cvra/carte-alim/Gerber/Seeedtudio_param.png

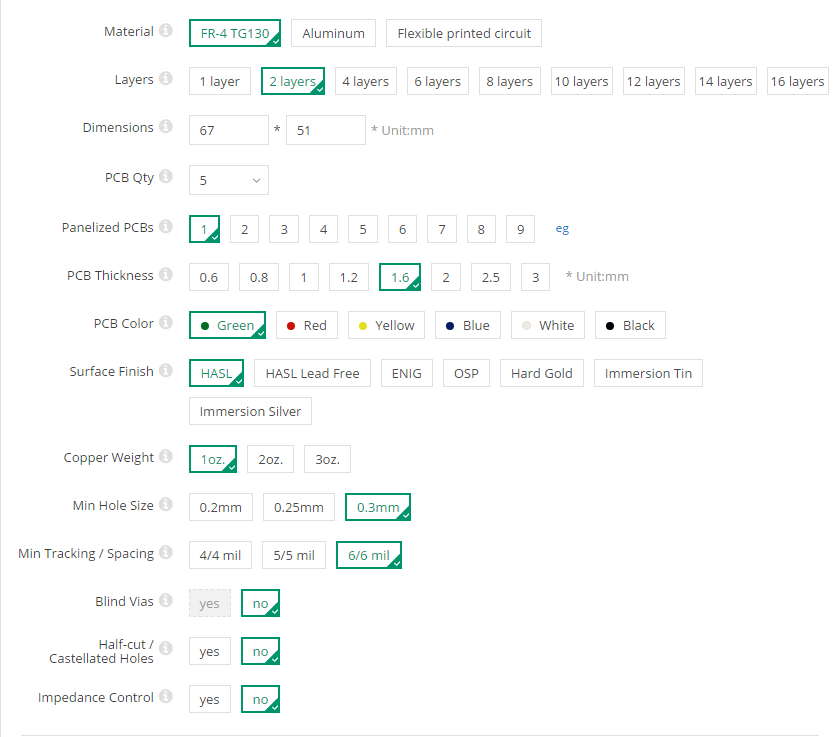
Gerber/Seeedtudio_param.png
