cvra/carte-alim/img/PCB_CarteAlim2017.png

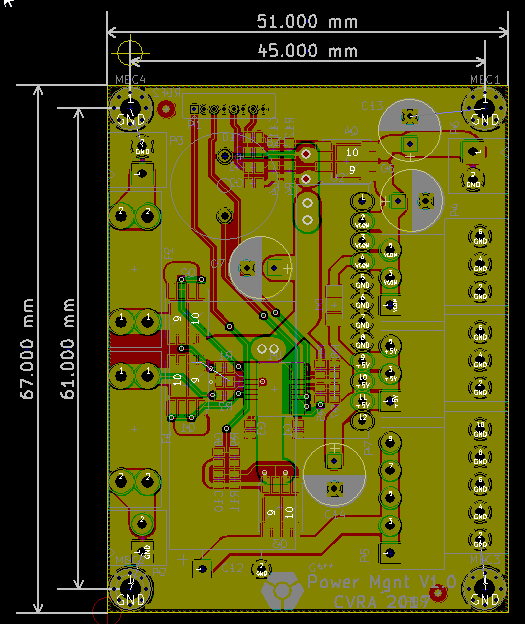
img/PCB_CarteAlim2017.png
