cvra/carte-alim/BOM_CarteAlim2017.xlsx

Id | Référence | Boîtier | Qu/PCB | Qu à cmd | Designation | Fournisseur | No Fournisseur
1 | C1,C3 | _0603 | 2 | 0 | NC
2 | C2,C8,C9 | _0603 | 3 | 9 | 1nF | Digikey | 478-1215-1-ND
3 | C4,C10,C11 | _0603 | 3 | 0 | 47nF | Digikey | 311-1427-1-ND
4 | C5 | _0603 | 1 | 0 | 0.1uF | Digikey | 399-5089-1-ND
5 | C6,C7,C13,C14 | CP_Radial_D8.0mm_P3.50mm | 4 | 12 | 100uF | Digikey | P12392-ND
6 | C12 | CP_Radial_L31.50D16.00P7.50_H | 1 | 3 | 3.3mF | Digikey | 565-3927-ND
7 | D1 | D_MiniMELF_Standard | 1 | 0 | LL103C-GS08 | Digikey | LL103C-GS08CT-ND
8 | F1,F2 | FuseHolder-Keystone-3557-2 | 2 | 6 | 20A | Digikey | 36-3557-2-ND
9 | P1 | Molex-PicoBlade-8 | 1 | 3 | Picoblade | Digikey | WM1737-ND
10 | P2,P3,P6 | Bornier_2p_3.5H | 3 | 0 | PT 1,5/ 2-3,5-H | Phoenix Contact
11 | P4,P7 | _Pheonix_MKKDS-1-3-3.5mm | 2 | 0 | MKKDS 1/ 3-3,5 | Phoenix Contact
12 | P5 | _Pheonix_MKKDS-1-5-3.5mm | 1 | 0 | MKKDS 1/ 5-3,5 | Phoenix Contact
13 | R1,R2 | _0603 | 2 | 6 | 1k | Digikey | 311-1.00KHRCT-ND
14 | R3,R4,R9,R10,R11,R12 | _0603 | 6 | 0 | 100k | Digikey | 311-100KHRCT-ND
15 | R5,R6,R7,R8 | _0603 | 4 | 12 | R | Digikey
16 | U1 | TSSOP-20_4.4x6.5mm_Pitch0.65mm | 1 | 3 | LTC2952_TSSOP20 | Digikey | LTC2952CF#PBF-ND
17 | U2 | DCDC-Conv_Recom_R-5xxxPA | 1 | 3 | R-555.0PA | Digikey | 945-2315-5-ND
20 | Q1,Q2,Q3,Q4 | PowerPak-SO8_5.15x6.15mm_Pitch1.27mm | 4 | 12 | Si7997DP | Digikey | SI7997DP-T1-GE3CT-ND
22 | BZ1 | _Buzzer_PUIAudio_AI-1433-TWT-R | 1 | 3 | Buzzer | Digikey | 668-1341-ND
 | P1 | Molex Picoblade 8 pin connector | 1 | 0 |  | Digikey | WM1726-ND
 | P1 | Contact picoblade 50079-8100 | 8 | 0 |  | Digikey | WM2023-ND
