cvra/carte-alim/CarteAlim2012.pdf

## Lipo 2...4S

6...16.8V

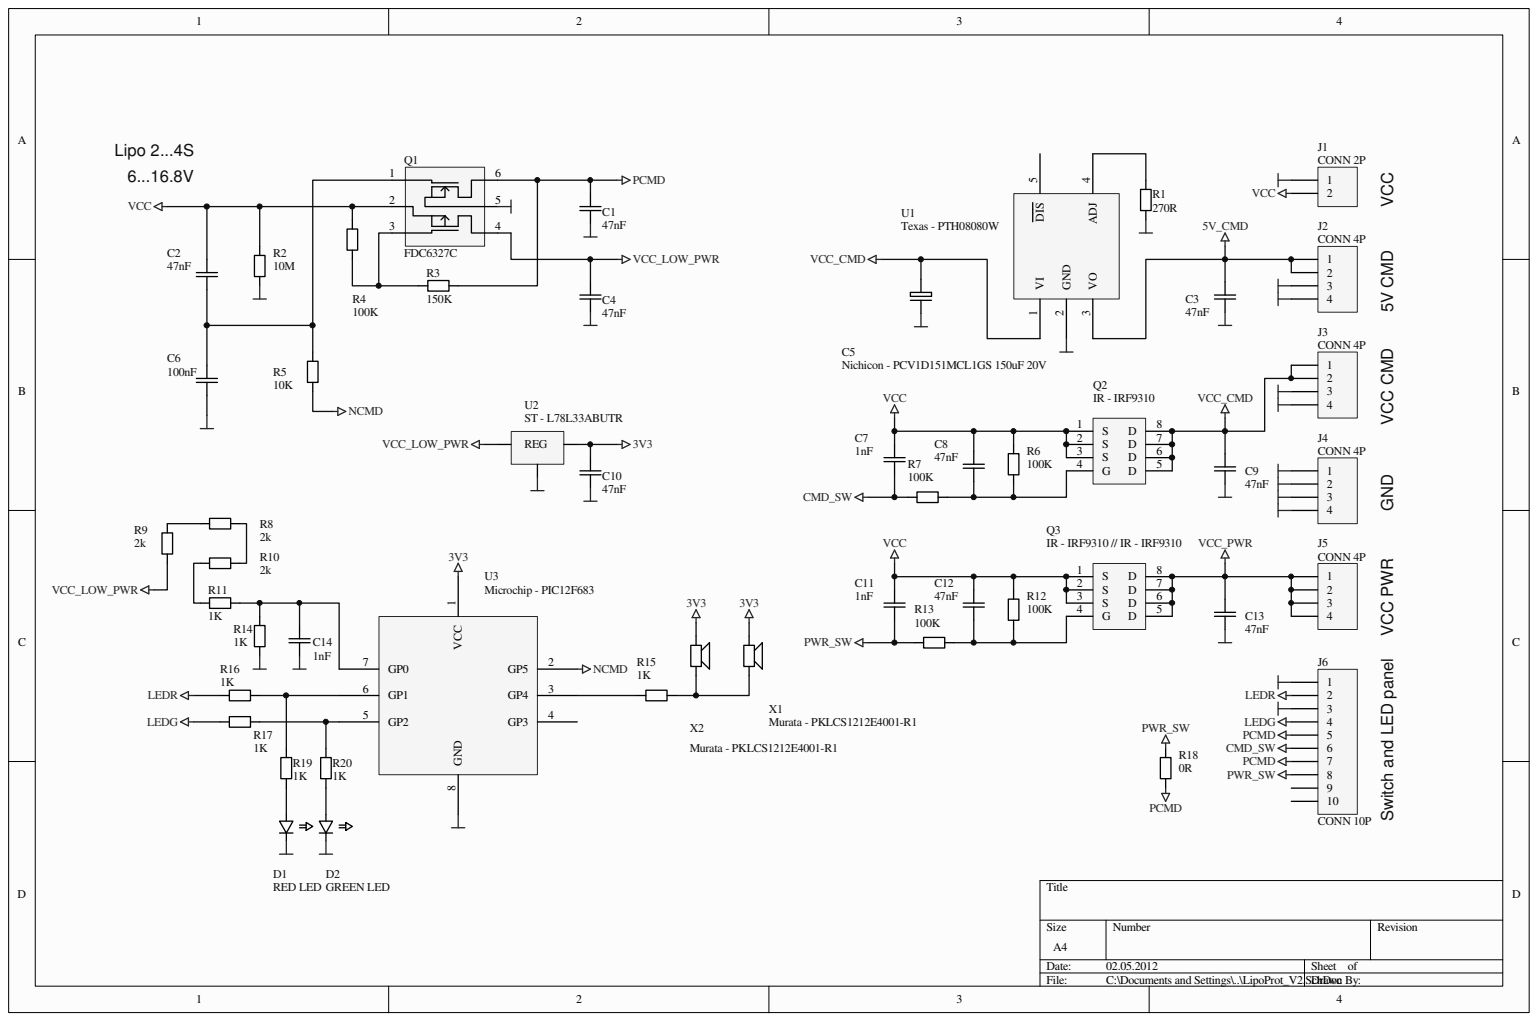
[picture p3: page 1]

Switch and LED panel
