cvra/carte-alim/CarteAlim2017.pdf

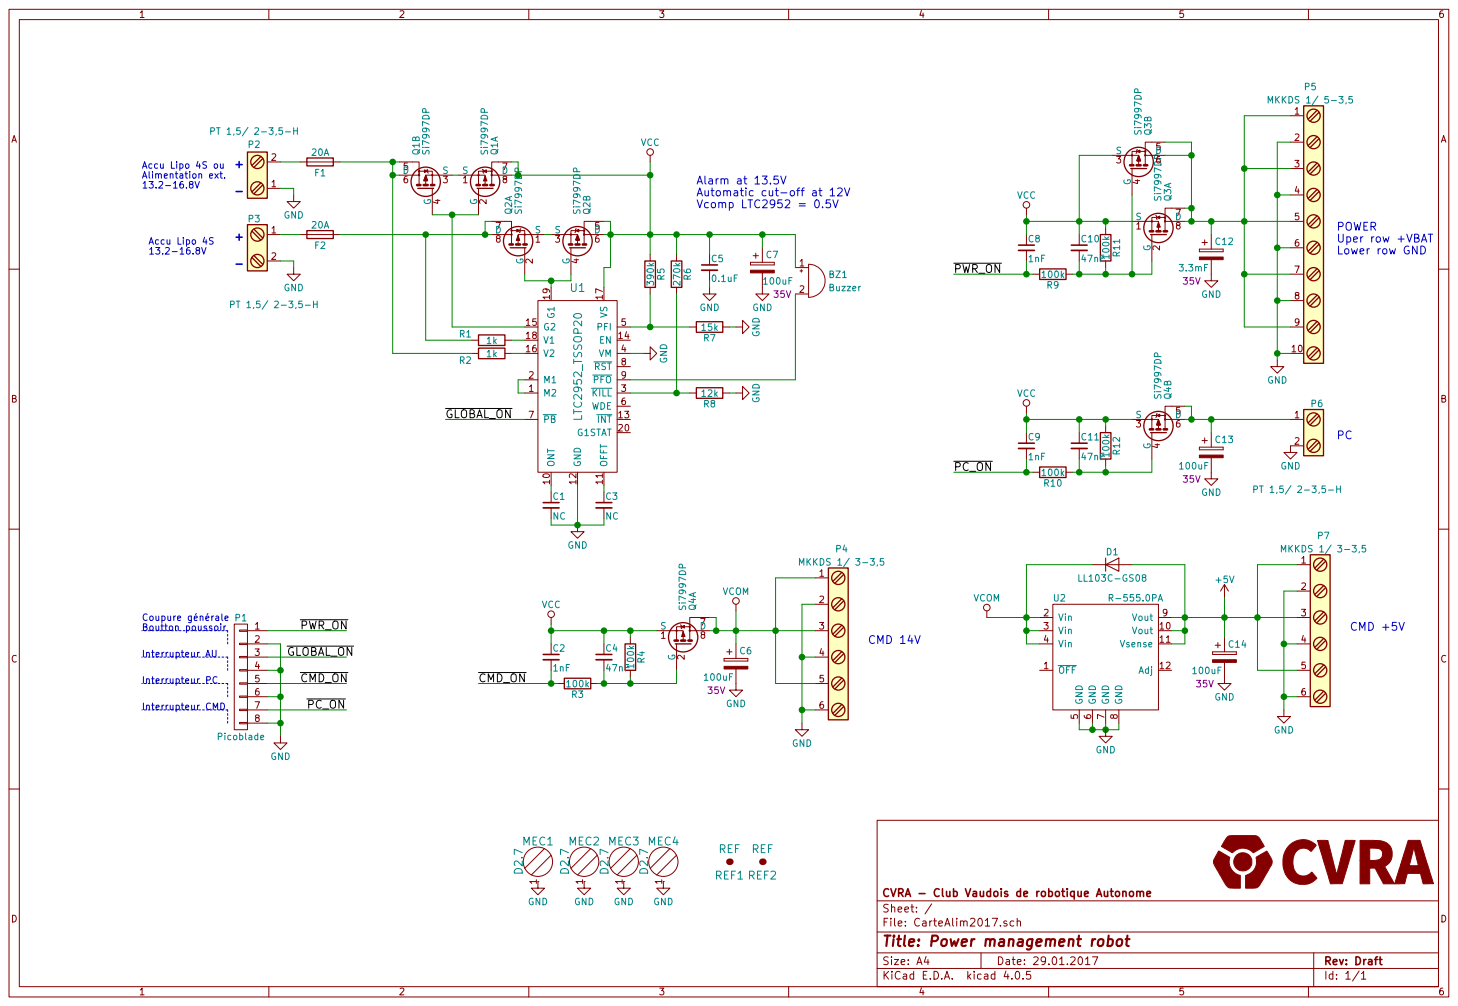
[picture p4: page 1]

Automatic cut-off at 12V
Vcomp LTC2952 = 0.5V

8 Vout 9 Vout 10 Vsense 11 Adj 12 U2 R-555.0PA GND

1 MEC4 D2.7 GND GND GND GND REF1 REF REF2 REF

Id: 1/1 Title: Power management robot File: CarteAlim2017.sch Sheet: / CVRA - Club Vaudois de robotique Autonome
