cvra/carte-alim/img/Assembly_bottom.pdf

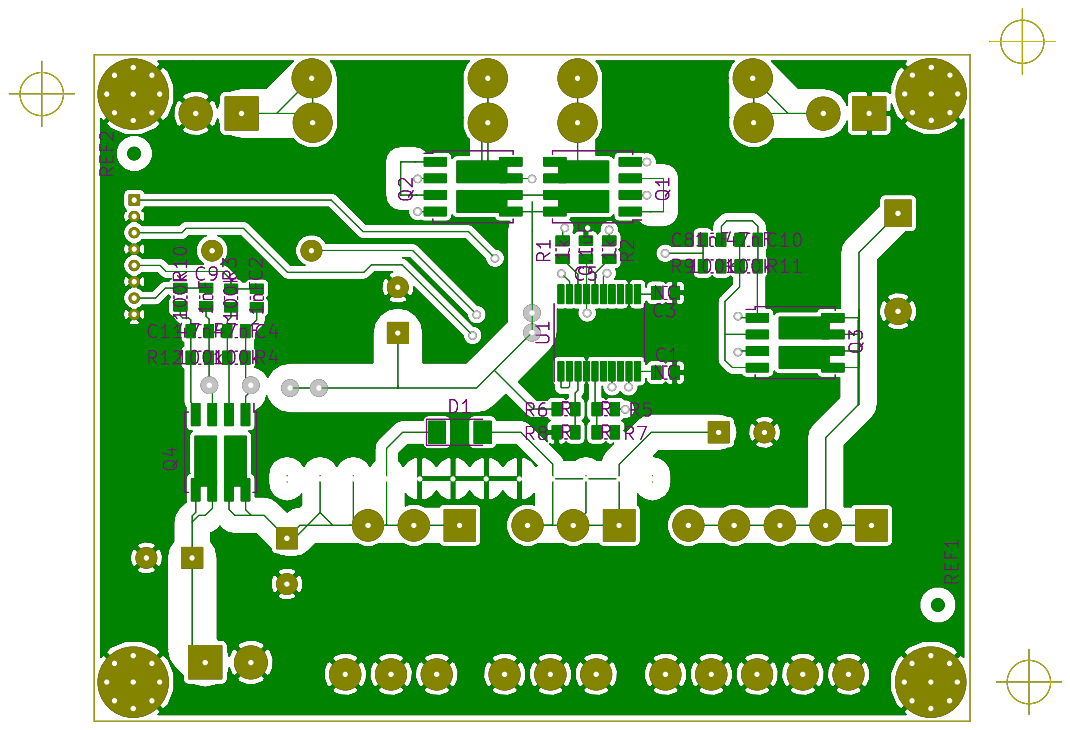
[picture p5: page 1]
