cvra/carte-alim/img/Assembly_top.pdf

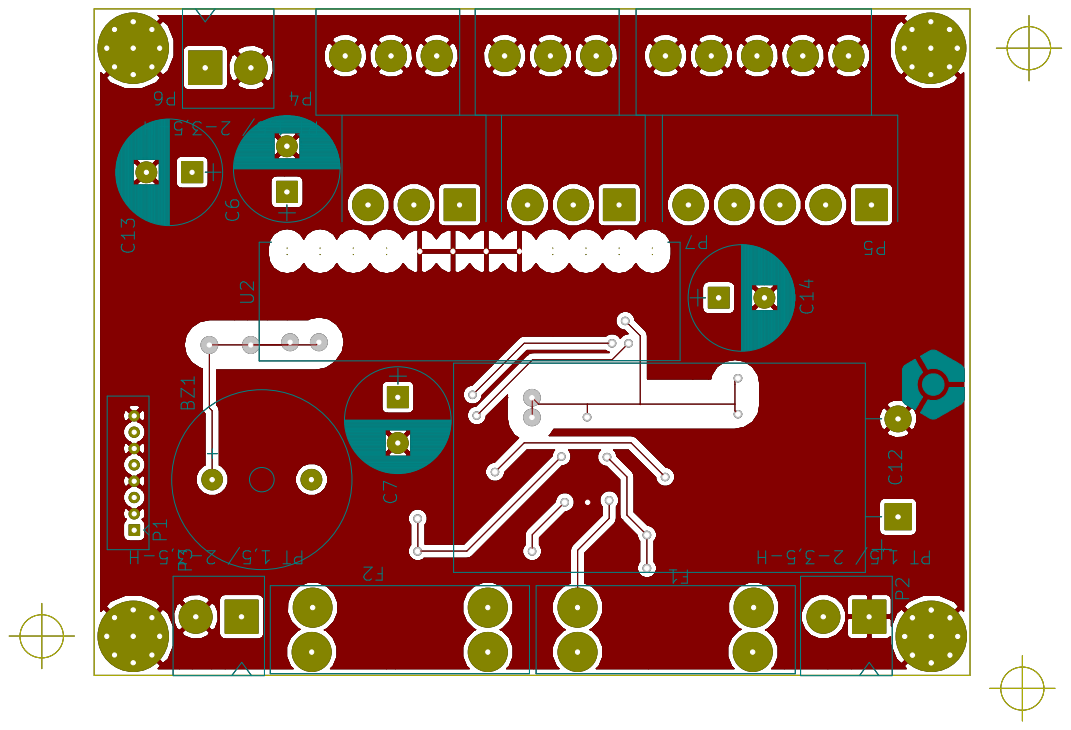
[picture p6: page 1]
