cvra/carte-alim/CarteAlim2017.kicad_pcb

## KiCad design CarteAlim2017.kicad_pcb (2020-03-16)

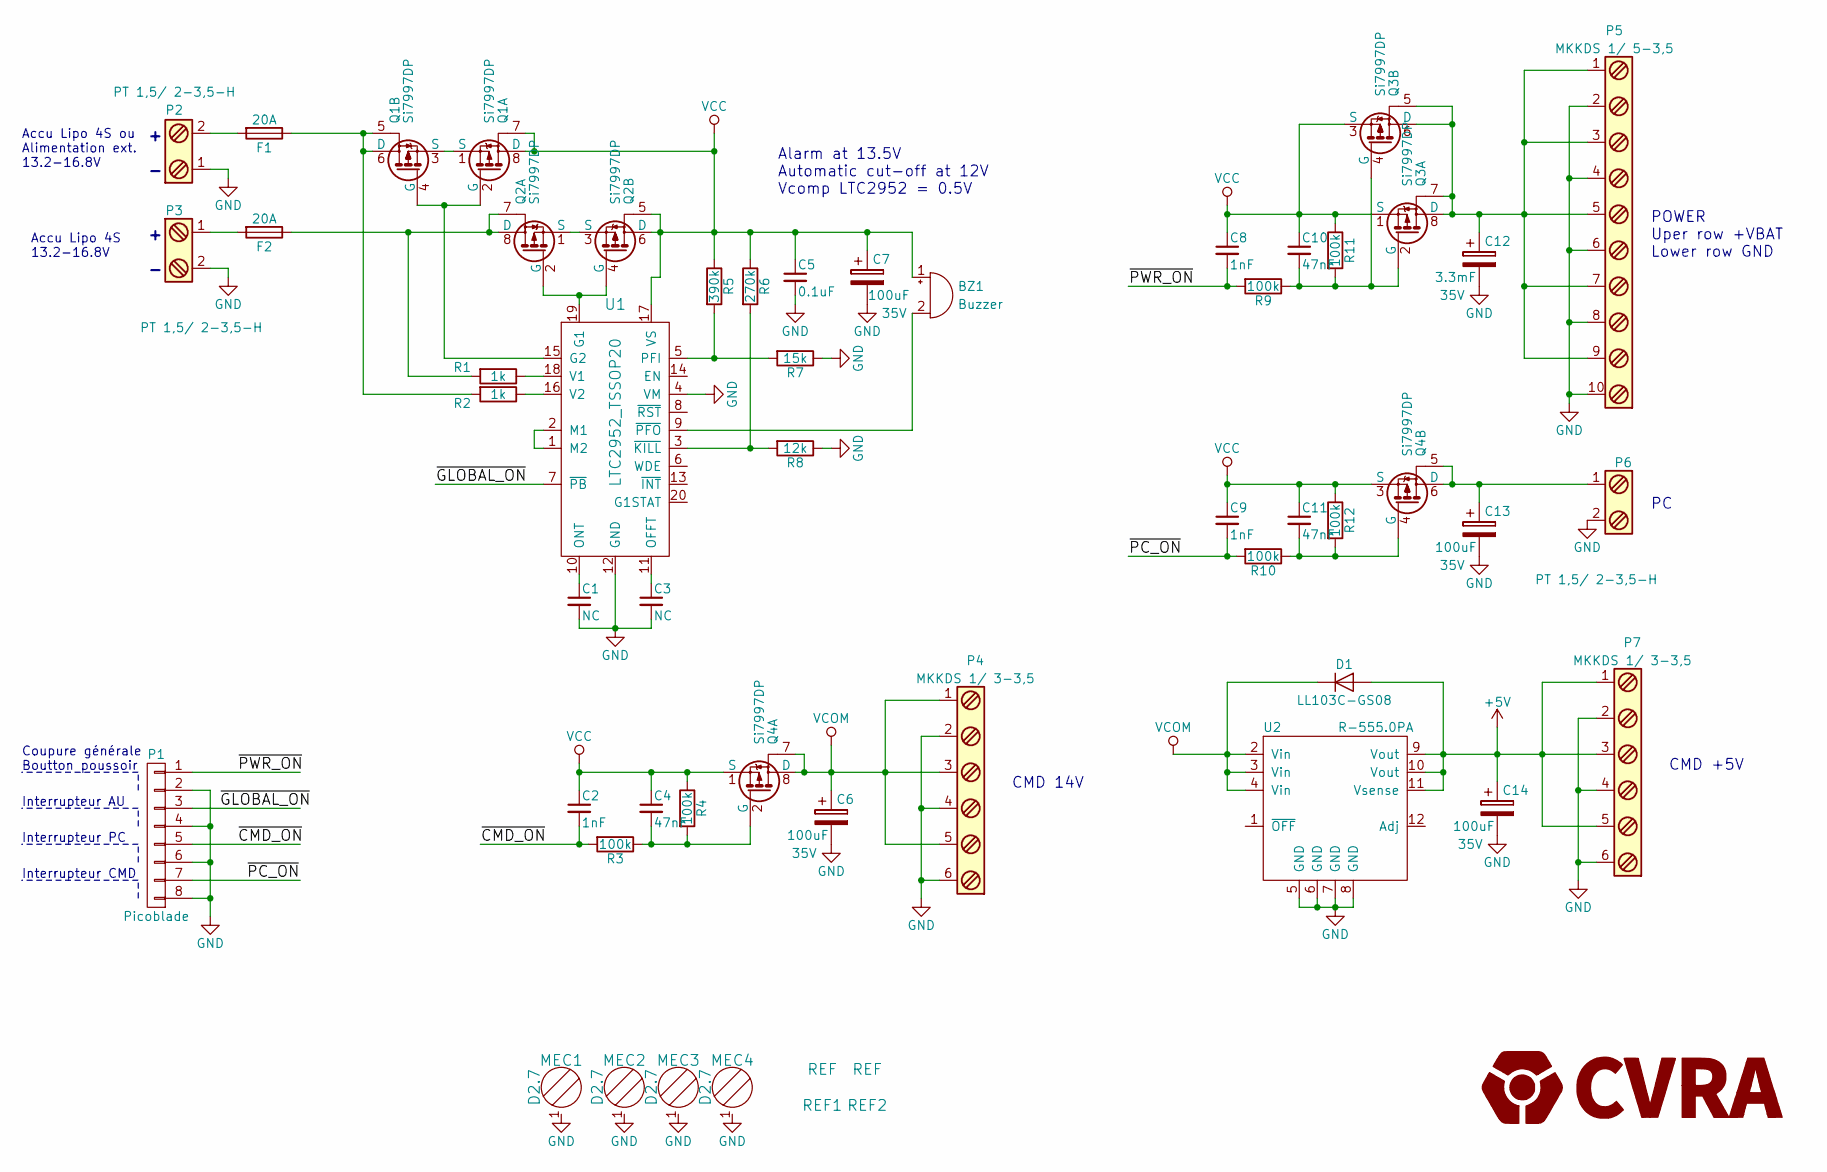
[picture p7: schematic CarteAlim2017.sch, Power management robot]

Parts:
BZ1: Buzzer; _Buzzer_PUIAudio_AI-1433-TWT-R; Digikey 668-1341-ND
C1, C3: NC; _0603
C2, C8, C9: 1nF; _0603
C4, C10, C11: 47nF; _0603
C5: 0.1uF; _0603
C6, C7, C13, C14: 100uF; CP_Radial_D8.0mm_P3.50mm; Digikey P12392-ND
C12: 3.3mF; CP_Radial_L31.50D16.00P7.50_H; Digikey 565-3927-ND
D1: LL103C-GS08; D_MiniMELF_Standard
F1, F2: 20A; FuseHolder-Keystone-3557-2
MEC1, MEC2, MEC3, MEC4: D2.7; MountingHole_2.7mm_M2.5_Pad_Via
P1: Picoblade; Molex-PicoBlade-8
P2, P3, P6: PT 1,5/ 2-3,5-H; Bornier_2p_3.5H
P4, P7: MKKDS 1/ 3-3,5; _Pheonix_MKKDS-1-3-3.5mm
P5: MKKDS 1/ 5-3,5; _Pheonix_MKKDS-1-5-3.5mm
Q1, Q2, Q3, Q4: Si7997DP; PowerPak-SO8_5.15x6.15mm_Pitch1.27mm
R1, R2: 1k; _0603
R3, R4, R9, R10, R11, R12: 100k; _0603
R5: 390k; _0603
R6: 270k; _0603
R7: 15k; _0603
R8: 12k; _0603
REF1, REF2: REF; Fiducial_1mm_Dia_2.54mm_Outer_CopperBottom
U1: LTC2952_TSSOP20; TSSOP-20_4.4x6.5mm_Pitch0.65mm
U2: R-555.0PA; DCDC-Conv_Recom_R-5xxxPA; Digikey 945-2315-5-ND

Connections:
+5V: C14.1, D1.2 (A), P7.1, P7.3, P7.5, U2.9 (Vout), U2.10 (Vout), U2.11 (Vsense)
/~CMD_ON: C2.2, P1.5, R3.2
/~GLOBAL_ON: P1.3, U1.7 (~PB)
/~PC_ON: C9.2, P1.7, R10.2
/~PWR_ON: C8.2, P1.1, R9.2
GND: C1.2, C3.2, C5.2, C6.2, C7.2, C12.2, C13.2, C14.2, MEC1.1, MEC2.1, MEC3.1, MEC4.1, P1.2, P1.4, P1.6, P1.8, P2.1, P3.2, P4.2, P4.4, P4.6, P5.2, P5.4, P5.6, P5.8, P5.10, P6.2, P7.2, P7.4, P7.6, R7.1, R8.1, U1.4 (VM), U1.12 (GND), U2.5 (GND), U2.6 (GND), U2.7 (GND), U2.8 (GND)
unnamed: BZ1.2 (+), U1.9 (~PFO)
unnamed: C1.1, U1.10 (ONT)
unnamed: C3.1, U1.11 (OFFT)
unnamed: C4.2, Q4.2 (G), R3.1, R4.2
unnamed: C10.2, Q3.2 (G), Q3.4 (G), R9.1, R11.2
unnamed: C11.2, Q4.4 (G), R10.1, R12.2
unnamed: C12.1, P5.1, P5.3, P5.5, P5.7, P5.9, Q3.5, Q3.6 (D), Q3.7, Q3.8 (D)
unnamed: C13.1, P6.1, Q4.5, Q4.6 (D)
unnamed: F1.1, Q1.5, Q1.6 (D), R2.2
unnamed: F1.2, P2.2
unnamed: F2.1, Q2.7, Q2.8 (D), R1.2
unnamed: F2.2, P3.1
unnamed: Q1.1 (S), Q1.3 (S)
unnamed: Q1.2 (G), Q1.4 (G), U1.15 (G2)
unnamed: Q2.1 (S), Q2.3 (S)
unnamed: Q2.2 (G), Q2.4 (G), U1.19 (G1)
unnamed: R1.1, U1.18 (V1)
unnamed: R2.1, U1.16 (V2)
unnamed: R5.2, R7.2, U1.5 (PFI)
unnamed: R6.2, R8.2, U1.3 (~KILL)
unnamed: U1.1 (M2), U1.2 (M1)
VCC: BZ1.1 (-), C2.1, C4.1, C5.1, C7.1, C8.1, C9.1, C10.1, C11.1, Q1.7, Q1.8 (D), Q2.5, Q2.6 (D), Q3.1 (S), Q3.3 (S), Q4.1 (S), Q4.3 (S), R4.1, R5.1, R6.1, R11.1, R12.1, U1.17 (VS)
VCOM: C6.1, D1.1 (K), P4.1, P4.3, P4.5, Q4.7, Q4.8 (D), U2.2 (Vin), U2.3 (Vin), U2.4 (Vin)

Notes on the sheet:
POWER Uper row +VBAT Lower row GND
CMD +5V
CMD 14V
Coupure générale Boutton poussoir
Interrupteur AU
Interrupteur PC
Interrupteur CMD
Accu Lipo 4S 13.2-16.8V
Accu Lipo 4S ou Alimentation ext. 13.2-16.8V
+ -
Alarm at 13.5V Automatic cut-off at 12V Vcomp LTC2952 = 0.5V

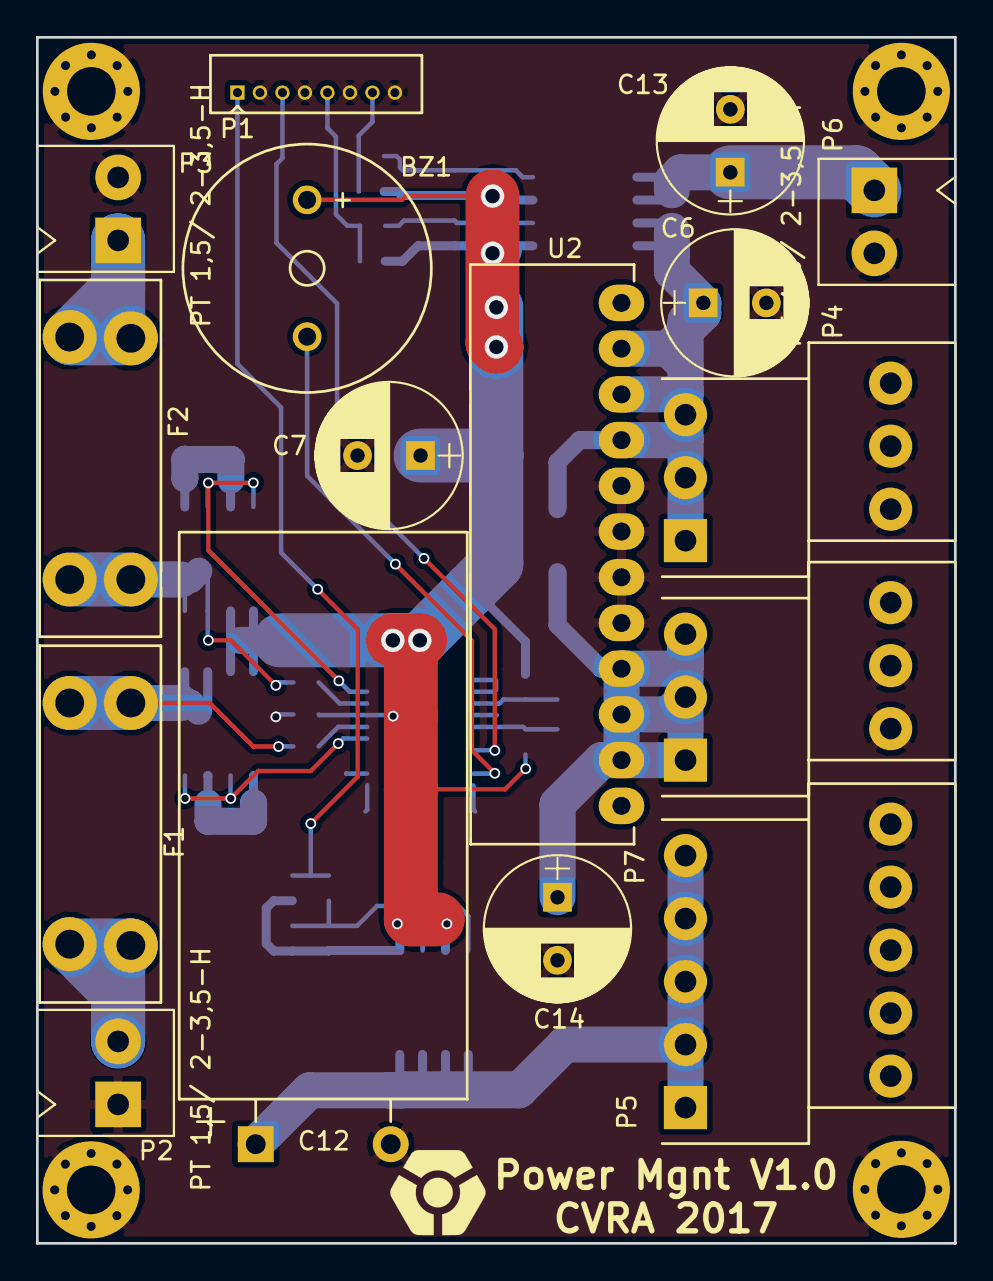
[picture p8: board CarteAlim2017.kicad_pcb from above]

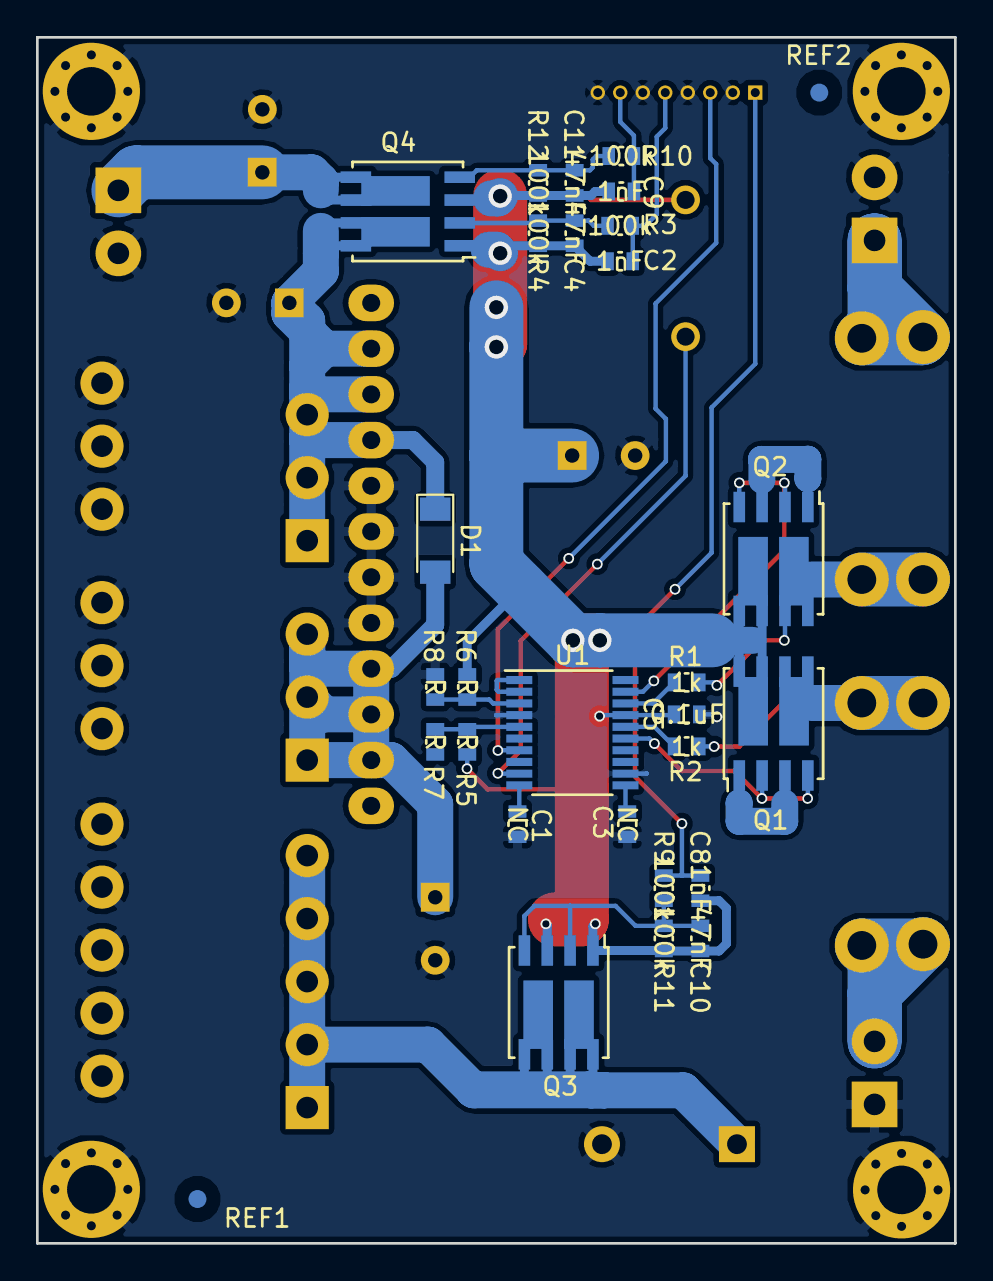
[picture p9: board CarteAlim2017.kicad_pcb from below]

Board: 2 copper layers, 51.0 x 67.0 mm, 49 parts (27 on the bottom side), 29 nets.
